bertoncelj1/MC_tester/README.md

# MC_tester

Tester for MC 330 and MC 350 devices.
