bertoncelj1/MC_tester/doc/Navodila za uporabo preizkuševalnika naprav MC 330 in MC 350.docx

# Navodila za uporabo preizkuševalnika naprav MC 330 in MC 350

Ko vključimo preizkuševalnik, se nam na zaslonu prikaze meni za izbiro naprave. S tipkami <, > in OK izberemo želeno testno naprav.

Po izbiri tipa testne naprave preizkuševalnik čaka, da priklopimo našo testno napravo. Z klikom na gumb OK, se lahko vrnemo v meni za izbiro naprave.

Program samodejno zazna vstavljeno napravo in takoj začne s testom. Odvisno od tipa testne naprave, ki smo jo izbrali na začetku, bo program izvedel različne testne operacije.

Testne operacije za naprave MC 330:

- Preveri pine: Samodejno preveri vse predpisane pine za morebitni stik. V primeru napake se zaslon izpiše, kateri piki so v stiku.
- Preveri backlight: Samodejno preveri napetost in tok osvetlitev ozadja. V primeru neveljavne napetosti in toka se na zaslon izpiše
- Preveri flash off: Samodejno preveri, ali je spomin nameščen v napravi. Če je, javi napako.
- Preveri tipke: Preverja delovanje tipk na testni napravi. V tej operaciji program čaka, da pritisnemo vse tipke na testni napravi. Na zaslonu se prikažejo tipke, ki smo ji že pritisnili. Ko pritisnemo vse tipke gre program samodejno naprej. Po pritisku posamične tipke se na zaslon testne naprave izrisujejo različne oblike, s katerimi preverimo delovanje zaslona. Program delovanje zaslona ne more preveriti sam, zato mora to preveriti uporabnik!

Testne operacije za naprave MC 350:

- Preveri pine: Enako kot pri MC 330.
- Preveri ledice: Na testni napravi začneta utripati ledici »alert« in »pulse«. Sami preverimo, če ledici pravilno utripata.
- Preveri backlight: Enako kot pri MC 330.
- Preveri flash: Samodejno preveri delovanje spomina. V primeru napake izpiše obvestilo.
- Preveri tipke: Enako kot pri MC 330.

V kateremkoli delu testa lahko z gumbom OK ponastavimo test.

V primeru, da se katerakoli od operacij zazna napako, se na zaslonu izpišejo podrobnosti napake. Test lahko ponovimo z klikom na OK, ali pa izklopimo napravo, kar nas vrne nazaj na prvi zaslon.

Če so se vsi testi pravilno izvedli, se na zaslon izpiše TEST KONČAN. Testno napravo lahko sedaj odstranimo in vstavimo novo.
