bertoncelj1/MC_tester/doc/SCH.PDF

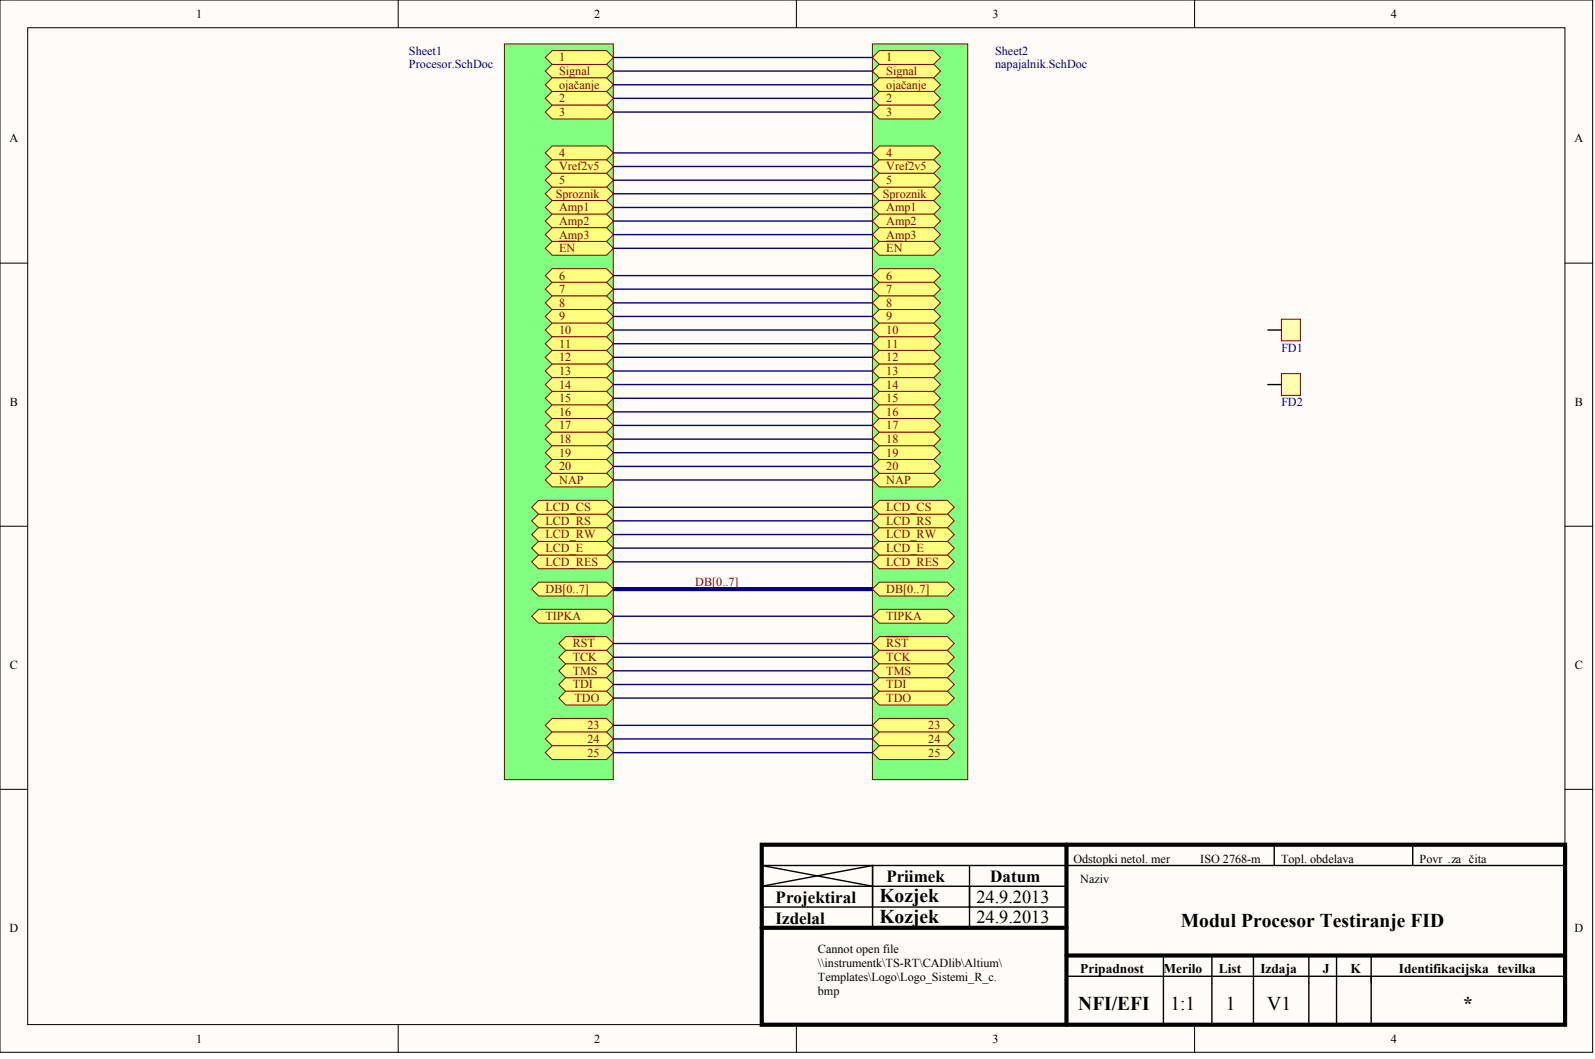
[picture p7: page 1]

Odstopki netol. mer ISO 2768-m | Topl. obdelav a | Povr? . za? čita

Priimek | Datum | Naziv

Projektiral | Kozjek | 24.9.2013 | Modul Procesor Testiranje FID
Izdelal | Kozjek | 24.9.2013

Cannot open file \\instrumentk\TS-RT\CADlib\Altium \ Templates\Logo\Logo_Sistemi_R_c. bmp

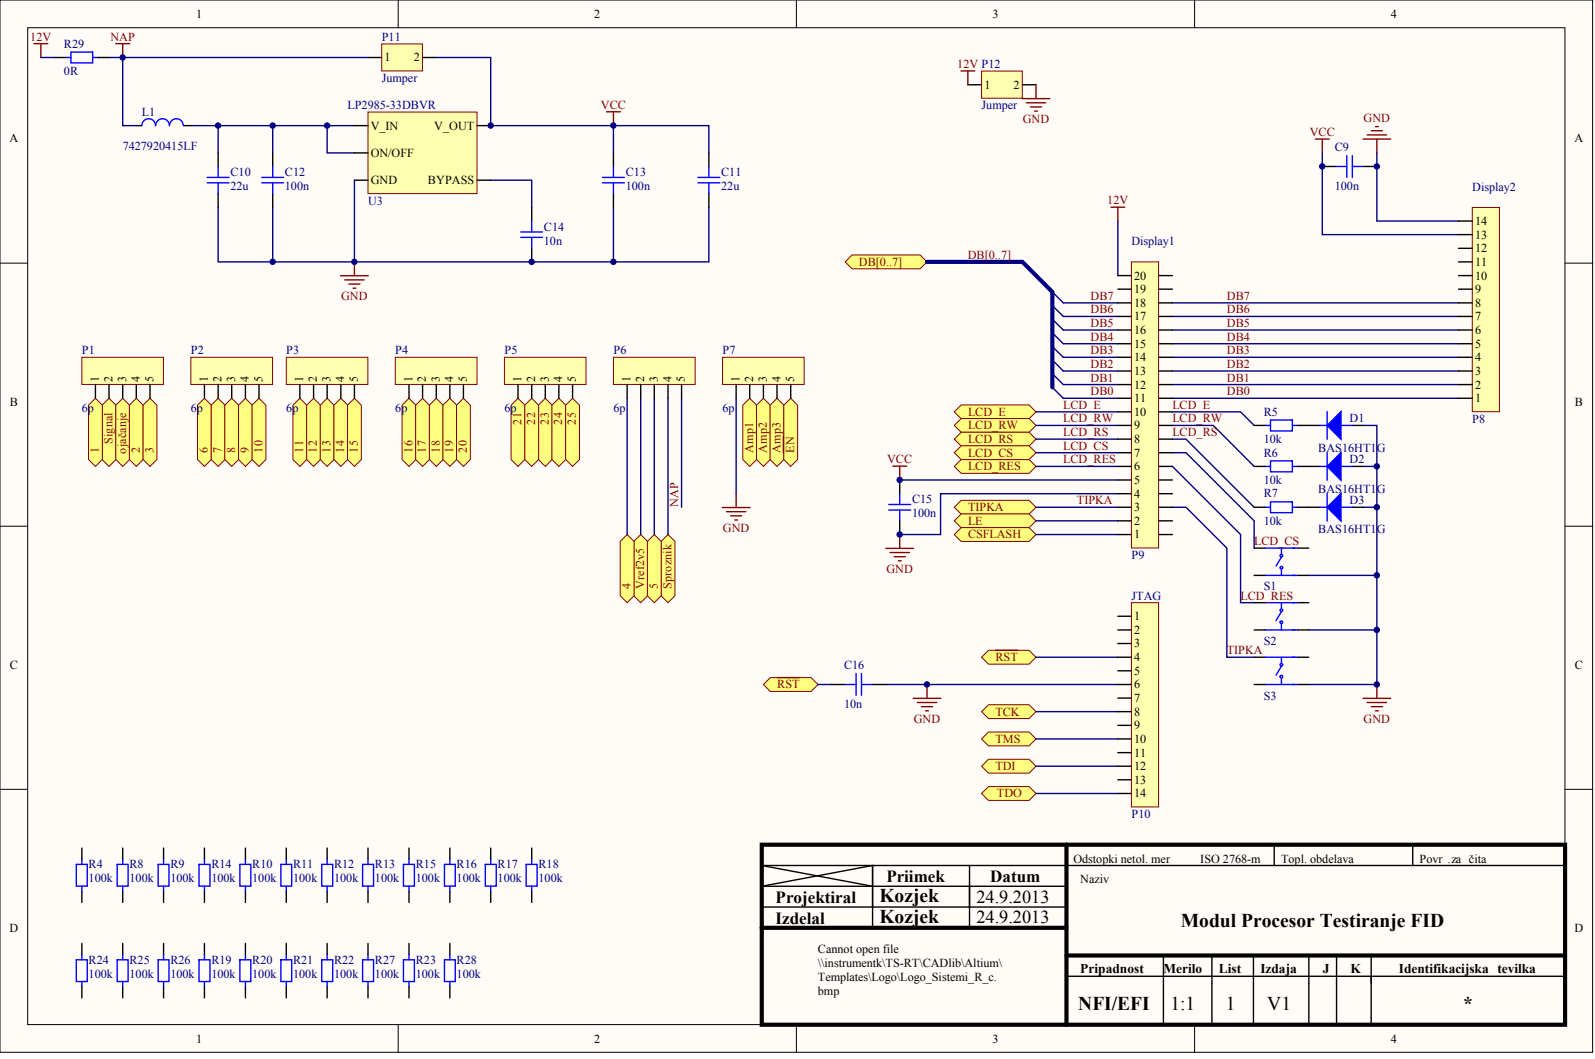
[picture p8: page 2]

Odstopki netol. mer ISO 2768-m | Topl. obdelava | Povr? . za? čita

Priimek | Datum | Naziv

Projektiral | Kozjek | 24.9.2013 | Modul Procesor Testiranje FID
Izdelal | Kozjek | 24.9.2013

Cannot open file \\instrumentk\TS-RT\CADlib\Altium\

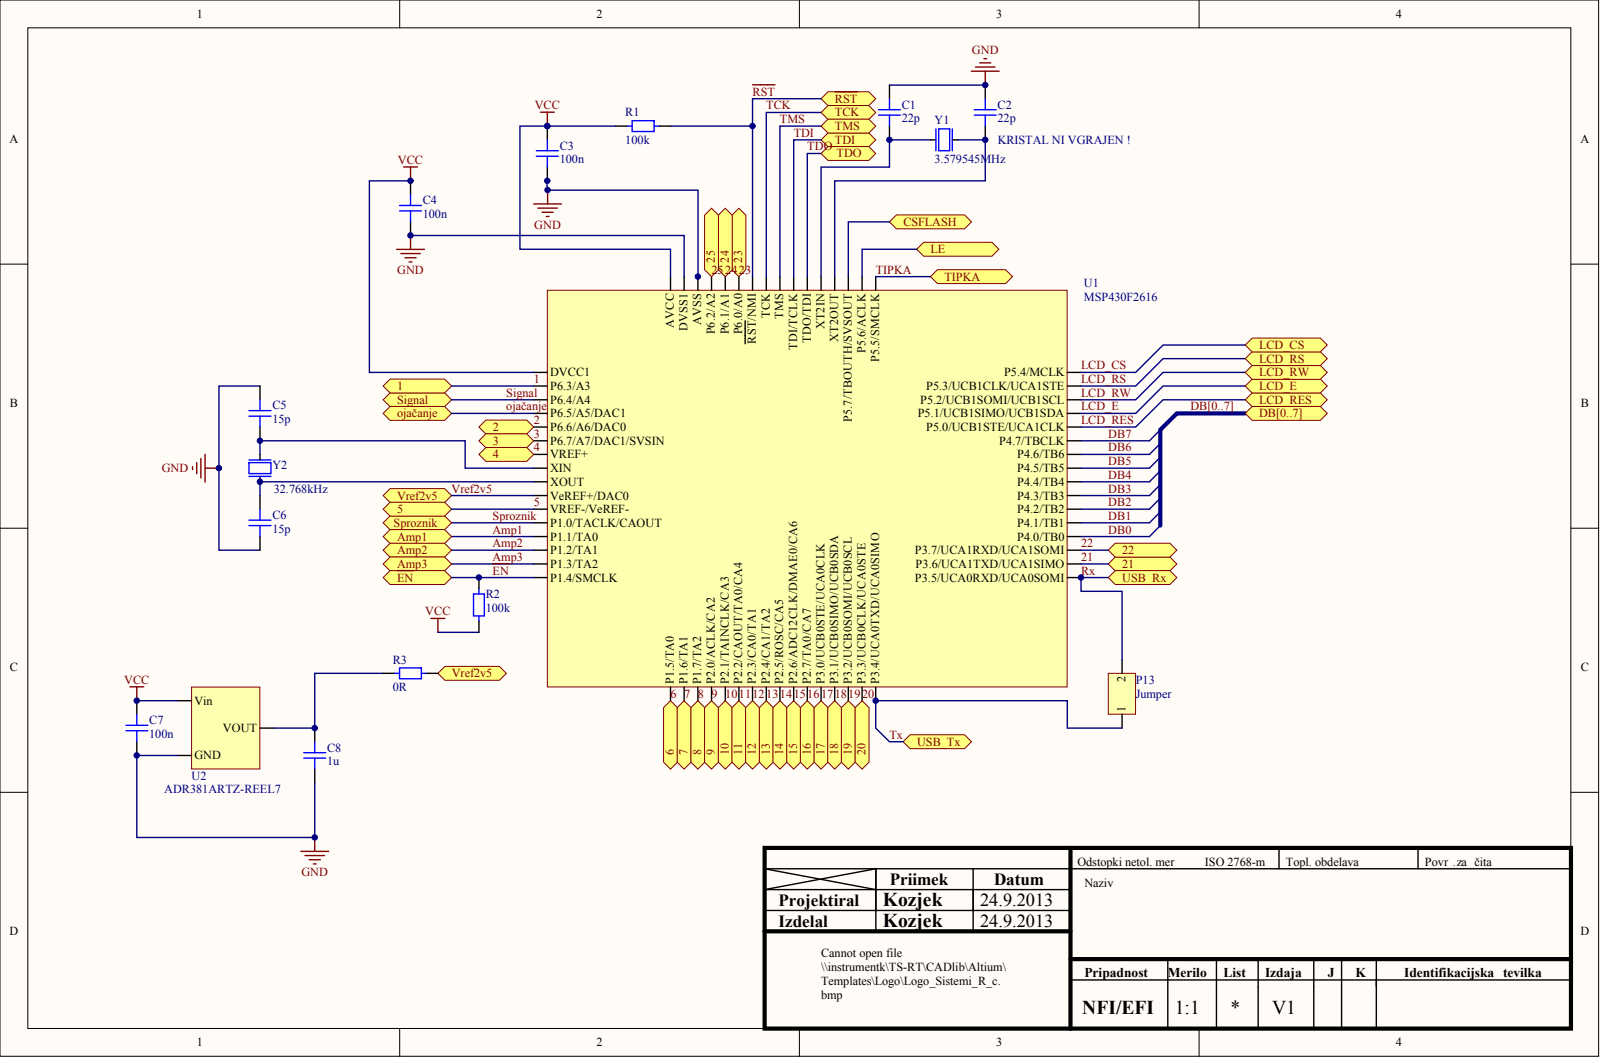
[picture p9: page 3]

Odstopki netol. mer ISO 2768-m | Topl. obdelav a | Povr? . za? čita

Priimek | Datum | Naziv

Projektiral | Kozjek | 24.9.2013
Izdelal | Kozjek | 24.9.2013

Cannot open file \\instrumentk\TS-RT\CADlib\Altium \

NFI/EFI | 1:1 | * | V1
