bertoncelj1/MC_tester/src/testi/error_mng.h

#ifndef error_mng_h
#define error_mng_h

#define ERR_BUFF_SIZE	100

//izpis
#define ST_CRK_NA_VRSTO	20 //koliko znakov bo izpisal na vrstico
#define POL_EKRANA		64
#define FONT_NASLOV		STDOUT_LCD_NORMAL_FONT
#define FONT_BESEDILO	        STDOUT_LCD
#define FONT_WIDTH              8 
#define MARGIN_TOP		13
#define MARGIN_LEFT		5
#define LINE_SPACE		8	//koliko so narazen vrstice sporocila
#define OPIS_SPACE		10	//koliko je razmika med opisom in sporocilom
#define NASLOV_SPACE	        12	//koliko je razmika med naslovem in opisom

void addToErrorBuff(char * str);
void emptyErrorBuff();
void izpisiError(char *imeNapake, char *opisNapake);

#else
	#error error_mng_h  already included! 
#endif
